YuuFukuyama/RabbitEnvironmentSystem/firmware/usart.md

# USART

STM32F103CBT6 と ESP32-C3 の間は、USART を非同期（UART）で使う。ESP32-C3 側のピン、AT コマンド、給電の電流は [esp32-c3-devkitm-1.md](esp32-c3-devkitm-1.md)、STBee Mini のピン番号は [stbee-mini-v2.md](stbee-mini-v2.md) にある。測定値の並び、応答タイムアウト、再接続の待ちは詳細設計の未決定項目のままである。

## 信号

TX はその部品の送信、RX はその部品の受信である。相手の TX をこちらの RX へ、相手の RX をこちらの TX へつなぐ。

同期モードのクロック（CK）は出さない。CTS と RTS も使わない。フロー制御は無しである。

この型番にあるのは USART1、USART2、USART3 である。USART1 のクロックは APB2 の 72 MHz、USART2 と USART3 は APB1 の 36 MHz である。115200 baud はどちらでも出せる。

ピンを USART の TX または RX に割り当てると、そのピンは GPIO ではなく USART が駆動する。

## 配線

信号と電源は 4 本である。

| STBee Mini | ESP32-C3 基板 |
| --- | --- |
| 31 番 PA9（USART1_TX） | J3 の 9 番（GPIO6、UART1 RX） |
| 32 番 PA10（USART1_RX） | J3 の 8 番（GPIO7、UART1 TX） |
| 39 番 5V | J1 の 13 番または 14 番（シルク 5V） |
| 40 番 GND | GND |

2 番は 39 番と同じ 5 V である。配線に使うのは、PA9 / PA10 と同じ列の 39 番と 40 番である。

論理レベルは 3.3 V。TX はプッシュプルで H も L も駆動するので、外部プルアップは付けない。5 V へプルアップすると、5 V を受けられない ESP32-C3 の GPIO を壊す。

給電は ESP32-C3 基板のシルク 5V へ入れる。このピンは TX / RX の列（J3）ではなく、反対側の列（J1）にあり、Micro-USB の 5 V と同じレールである。基板上の LDO がモジュール用の 3.3 V を作る。STBee Mini の 3.3 V（3 番、38 番）から ESP32-C3 の 3V3 ピンへは給電しない。3V3 ピンは LDO の出力である。Wi-Fi 送信のピークが、STBee Mini の 3.3 V 出力の定格を超える。USB ケーブルを挿したまま、5V ピンへ別の 5 V を入れない。

ESP32-C3 基板のシルク TX / RX（GPIO21 / GPIO20）は、PC への書き込みとログ用である。STM32 はここへつながない。CH340C と信号が衝突する。

## 採用するピン

USART1 を使う。TX は PA9（31 番）、RX は PA10（32 番）である。クロックは APB2 の 72 MHz で、入力は 5 V を受けられる。相手の信号は 3.3 V である。

使わない組は次のとおり。

| 周辺 | TX | RX | 基板ピン | 使わない理由 |
| --- | --- | --- | --- | --- |
| USART2 | PA2 | PA3 | 24 番、25 番 | 5 V 入力は不可。5 V ピンから遠い |
| USART3 | PB10 | PB11 | 14 番、15 番 | このパッケージの I2C2 ピンである |

使わない兼用は次のとおり。

- USART1 の別ピン PB6 / PB7 は I2C1 の SCL / SDA である。
- USART1_CK は PA8（30 番）。同期クロックは出さないので、GPIO のまま空ける。
- USART1 の CTS / RTS（PA11 / PA12）は USB の D− / D+ と兼用である。
- PA13 / PA14 は SWD のまま残す。

## 通信条件

ESP-AT の UART1 に合わせる。

- 115200 baud、8 ビット、パリティなし、ストップ 1。
- 行末は CR LF（`\r\n`）。
- フロー制御なし。
- ボーレートは `AT+UART_DEF` で変えない。115200 のままにする。

## このリポジトリでの割り当て

CubeMX は USART1 を非同期で初期化する。`MX_USART1_UART_Init` が `HAL_UART_Init` を呼び、失敗すると `Error_Handler()` に入る。設定は 115200 baud、8 ビット、パリティなし、ストップ 1、フロー制御なしである。TX は PA9、RX は PA10 で、割り込みは使わない。測定のたびに `AT` と `AT+GMR` を送り、`OK` を読む。`AT+GMR` は応答に `MINI-1` があることも見る。続けて `AT+CWSTATE?` を見る。IP を持っていれば `AT+CWJAP` は送らない。未接続のときだけ `AT+CWMODE=1` と `AT+CWJAP` を送る。SSID とパスワードは `STM32CubeMx/App/wifi_secret.h` に書き、このファイルは git に入れない。失敗しても測定周期は続ける。

- USART1 の TX は PA9（31 番）、RX は PA10（32 番）。ESP32-C3 の UART1 は、GPIO6 が RX、GPIO7 が TX である。
- 給電は 39 番の 5 V を、ESP32-C3 のシルク 5V（J1 の 13 番または 14 番）へ入れる。GND は 40 番である。3 番と 38 番の 3.3 V からは給電しない。
- 5 V 電源は 0.5 A 以上を出せるものとする。Wi-Fi 送信のピークは最大 350 mA、受信は 82 mA である。STM32 本体は約 30 mA で、同じ USB の 5 V から STBee Mini のレギュレータを経由する。10 分に 1 回の送信なら、5 V で 0.5 A 以上出せる USB アダプタか給電ポートでピークは収まる。USB 機器として認識されていない PC ポートは 100 mA しか出さないことがあり、その場合は足りない。
- ESP32-C3 をつないだまま、STBee Mini の 5 V ピンへ 9〜12 V は入れない。リセッタブルヒューズの保持電流はマニュアルに無い。
- 測定と LCD 更新の周期は、USART の成否で変えない。
- AT や Wi-Fi の失敗では `Error_Handler()` に入らない。センサー通信の失敗と同じである。

## 起動時の HTTP（notifyMode 取得）

起動時の操作取得は `GET /v1/ops` である。中継は本文 `0` または `1` の 1 文字だけ返す。本体は `At_BootParseNotifyMode` で読んで `EnvJudge_SetNotifyMode` に渡す。暦は中継から取らず RTC へも書かない。取得失敗時は測定周期を続行し、LCD には診断を出さない。`At_HttpAuthBoot` は `Authorization` ほかと `X-Device-Boot: 1` を `AT+HTTPCHEAD` で載せる。`At_HttpGetBoot` は `ATE0` のあと `AT+HTTPCSNI` を host に合わせ、順に `AT+HTTPCGET="https://<RELAY_HOST>/v1/ops",2048,2048,20000`、host/path 指定の `AT+HTTPCLIENT`、URL 一体型 `AT+HTTPCLIENT` を試す。UART 受信バッファ 2048 バイトで、行頭の `+HTTPCGET:` / `+HTTPCLIENT:` から本文を行末まで連結する（分割 URC と `0`/`1` だけの続き行にも対応）。0/1 が読めるまで、またはタイムアウト（20 s）まで読む。`OK` の後も短いアイドル（約 1.2 s）を含め追加 URC を待つ。連結後は 0/1 1 文字に切り詰める。マージ対象は行頭 URC のみ（`AT+HTTPCLIENT` エコー内の部分一致は除く）。
