YuuFukuyama/RabbitEnvironmentSystem/firmware/gy-sht31-d.md

# GY-SHT31-D 仕様メモ

RASBEE の GY-SHT31-D（Amazon ASIN [B08G4MXGXM](https://www.amazon.co.jp/dp/B08G4MXGXM)、メーカー型番 GY-SHT31-D）は、Sensirion SHT31-DIS を載せた I2C 温湿度モジュールである。販売名の SHT31-D は、デジタル I2C 版（DIS）を指す。

チップの数値と命令は [Datasheet SHT3x-DIS](https://sensirion.com/media/documents/213E6A3B/63A5A569/Datasheet_SHT3x_DIS.pdf)（2022年12月、Version 7）による。端子、基板上の抵抗、販売ページが掲げる範囲と精度は、上記商品ページの記載による。ページ内で数値が食い違う箇所は、その節に両方残す。

## 概要

温度と相対湿度を工場校正済みの 16 bit 値で返す。電源と温度の依存はチップ内で補正されている。

- 湿度の規定範囲は 0〜100 %RH。温度の規定範囲は −40〜125 ℃。
- 精度が出る推奨範囲は 5〜60 ℃、20〜80 %RH。ここを外して長く置くと、特に高湿で湿度が一時的にずれる。例として、80 %RH を超える状態を 60 時間続けると +3 %RH 程度ずれることがある。推奨範囲に戻すと、時間をかけて校正状態に戻る。
- I2C は 7 bit、最大 1 MHz。アドレスは 2 つから選べ、この基板の初期値は `0x44`。
- 測定しないあいだはアイドルになる。アイドルはユーザからは止められない。

チップ上面のレーザ印字の上段が `SHT31` である。`SHT30` の場合、温度の代表精度 ±0.2 ℃の範囲は 0〜65 ℃になり、湿度の公差グラフも別である。

## 販売ページの記載

商品ページが仕様として挙げている値は次のとおり。

| 項目 | ページの記載 |
| --- | --- |
| 電源 | DC 2.4〜5.5 V、代表 3.3 V。仕様表の最大供給電圧は 5.5 V |
| 湿度 | 0〜100 %RH、精度 ±2 %RH。応答は約 8 秒（τ63%） |
| 温度 | −40〜125 ℃、精度 ±0.3 ℃ |
| 出力 | デジタル。インターフェースは I2C、最大 1 MHz。アドレスは 2 つから選べる |
| センサ | SHT31-DIS |
| 実装 | サーフェスマウント |
| アラーム | 温度と湿度の上限・下限をプログラムでき、ALR で知らせる |

同じページのピン説明には、電源を 2.4〜5 V と書いた段と、2.5〜5 V と書いた段がある。箇条書きと仕様表は 5.5 V までである。チップのデータシートは 2.15〜5.5 V。このファームは代表値の 3.3 V で使う。

説明の一節に「アナログ出力」とある。同じページの仕様表はデジタル出力、ピン説明は I2C である。載っているセンサの型番は SHT31-DIS。別の段では「RH応答時間：0〜100 %RH」とあり、これは湿度の範囲と応答時間を取り違えた行である。応答時間として使うのは、約 8 秒（τ63%）の方である。

## 基板

商品ページの端子は次のとおり。ロジックの H レベルは、マイコンと同じ電圧を VIN に入れる。

| 端子 | ページの説明 |
| --- | --- |
| VIN | 電源。チップの VDD |
| GND | 電源とロジックの共通グランド |
| SCL | I2C クロック。VIN へ 10 kΩ でプルアップ |
| SDA | I2C データ。VIN へ 10 kΩ でプルアップ |
| ADR | アドレス選択。10 kΩ でプルダウンされ、開放時は `0x44`。VIN へつなぐと `0x45` |
| RST | ハードウェアリセット。10 kΩ でプルアップされ、開放時は動作状態。GND へ落とすとリセット |
| ALR | アラート出力。温度・湿度が設定範囲を外れたことを出す |

チップ側の対応は、ADR が ADDR、RST が nRESET（アクティブ L、パルス幅は最小 1 µs）、ALR が ALERT である。データシートでは、使わない ALERT はフローティングにする。nRESET を使わないときはフローティング、または 2 kΩ 以上で VDD へつなぐ。この基板は RST を 10 kΩ でプルアップしているので、開放のままでリセットは掛からない。

チップの VDD は 2.15〜5.5 V。2.4 V 未満では測定時間の最大が長くなる。電源ピンの直近には、データシートの推奨どおり 100 nF があるとみなす。センサ開口（チップ中央の穴）は、触れる、塞ぐ、濡らす、溶剤をかける、と測定が壊れる。基板は洗わない。

## 性能

商品ページの精度は、湿度 ±2 %RH、温度 ±0.3 ℃である。SHT31 データシートの代表精度は、湿度が ±2 %RH、温度が ±0.2 ℃（0〜90 ℃）である。最大公差はデータシートのグラフ（湿度は Figure 3 と Figure 6、温度は Figure 9）を見る。湿度の応答約 8 秒（τ63%）は、データシートの 8 s（25 ℃、風速 1 m/s）と一致する。

繰り返し性は、一定条件下で連続測定した標準偏差の 3 倍である。分解能は温度・湿度とも代表 0.01。

| 項目 | 湿度 | 温度 |
| --- | --- | --- |
| 繰り返し性 Low | 0.21 %RH | 0.15 ℃ |
| 繰り返し性 Medium | 0.15 %RH | 0.08 ℃ |
| 繰り返し性 High | 0.08 %RH | 0.04 ℃ |
| ヒステリシス | 25 ℃で ±0.8 %RH | |
| 応答 τ63% | 8 s（25 ℃、風速 1 m/s） | 2 s より長い |
| 長期ドリフト | 代表 <0.25 %RH/年（最大 <0.5） | 最大 <0.03 ℃/年 |

湿度の応答は実装で変わる。ART を有効にすると、湿度の応答時間は約半分になる。温度の応答は熱の逃げ方に依存する。

## 電気とタイミング

代表値は 25 ℃。最小・最大は −40〜125 ℃。

| 項目 | 最小 | 代表 | 最大 | 単位 |
| --- | --- | --- | --- | --- |
| VDD | 2.15 | 3.3 | 5.5 | V |
| パワーオンしきい値 VPOR | 1.8 | 2.10 | 2.15 | V |
| VDD のスルーレート | | | 20 | V/ms |
| アイドル（単発、25 ℃） | | 0.2 | 2.0 | µA |
| アイドル（単発、125 ℃） | | | 6.0 | µA |
| アイドル（周期測定） | | 45 | | µA |
| 測定中 | | 600 | 1500 | µA |
| 単発・最低繰り返し性・1 回/秒の平均 | | 1.7 | | µA |
| ヒータ | 3.6 | | 33 | mW |

VDD を最小と最大のあいだで動かすとき、スルーレートが 20 V/ms を超えるとリセットすることがある。ヒータ電力は電源電圧で変わる。

VDD が 2.4〜5.5 V のときの時間は次のとおり。2.15 V 以上 2.4 V 未満では、パワーアップ最大が 1.5 ms、測定最大が Low 4.5 ms、Medium 6.5 ms、High 15.5 ms になる。

| 項目 | 代表 | 最大 |
| --- | --- | --- |
| パワーアップ（VDD が VPOR 以上になってからアイドルまで） | 0.5 ms | 1 ms |
| ソフトリセット（ACK からアイドルまで） | 0.5 ms | 1.5 ms |
| nRESET パルス幅 | | 最小 1 µs |
| 測定 Low | 2.5 ms | 4 ms |
| 測定 Medium | 4.5 ms | 6 ms |
| 測定 High | 12.5 ms | 15 ms |

絶対最大定格は、VDD が −0.3〜6 V、各ピンが −0.3〜VDD+0.3 V、任意ピンの電流が ±100 mA、保存温度が −40〜150 ℃。動作を保証する範囲ではない。

## I2C

SCL は 0〜1000 kHz。400 kHz までは I2C Fast-mode、それを超えて 1 MHz まではデータシート Table 21 のタイミングに従う。SDA と SCL はオープンドレインで、外部プルアップが要る。バス容量の上限は、1 MHz のタイミング表では 400 pF。

7 bit アドレスは、ADDR が L のとき `0x44`、H のとき `0x45`。ADDR はフローティングにしない。レベルは START からその通信が終わるまで固定する。この基板は ADR を 10 kΩ でプルダウンしているので、開放なら `0x44` になる。VIN へつなぐと `0x45` になる。8 bit で送るアドレスバイトは、`0x44` の書き込みが `0x88`、読み出しが `0x89` である。

命令もデータも 16 bit で、上位バイトが先である。命令の 16 bit には 3 bit の CRC が既に含まれているので、命令のうしろに CRC バイトは付けない。センサが出すデータ、およびマスタが書くデータワードのうしろには 8 bit CRC が付く。書き込みでは CRC が正しいときだけ受け付ける。読み出しの CRC を検査するかはマスタの判断である。

ある命令のあと、次の命令までは 1 ms 以上空ける。各バイトの ACK は、8 個目の SCL の立ち下がり後に SDA を L にすることで示す。

## 単発測定

1 命令で温度と湿度を 1 組測る。繰り返し性で測定時間、ノイズ、測定中の電流量が変わる。クロックストレッチの有無は命令で選ぶ。

| 繰り返し性 | ストレッチ | 命令 |
| --- | --- | --- |
| High | あり | `0x2C06` |
| Medium | あり | `0x2C0D` |
| Low | あり | `0x2C10` |
| High | なし | `0x2400` |
| Medium | なし | `0x240B` |
| Low | なし | `0x2416` |

手順は次のとおり。

```text
START、アドレス+W、命令上位、命令下位、STOP
測定が終わるまで待つ
START、アドレス+R、温度上位、温度下位、CRC、湿度上位、湿度下位、CRC、NACK、STOP
```

温度が先、湿度が後。各値は符号なし 16 bit で、それぞれの直後に CRC がある。マスタは続けて読むバイトに ACK を返す。CRC を含めて 6 バイト読んだあと、最後のバイトには NACK と STOP を出す。CRC や湿度が不要なら、途中のバイトのあとで NACK して止めてよい。湿度も使うなら、温度 2 バイトとその CRC は読み、湿度 2 バイトのあとに NACK する。

ストレッチ無しの命令では、測定が終わっていない読み出しヘッダに NACK が返る。ストレッチありの命令では、読み出しヘッダに ACK したあと、測定が終わるまでセンサが SCL を L に保持する。終わると SCL を離し、6 バイトを送る。

## 周期測定

1 命令のあと、決めた周期で測定を続ける。ストレッチは選べない。結果は Fetch Data `0xE000` で読む。データが無いときの読み出しヘッダは NACK になる。Fetch で読むと、その測定値は消える。

| 周期 | High | Medium | Low |
| --- | --- | --- | --- |
| 0.5 回/秒 | `0x2032` | `0x2024` | `0x202F` |
| 1 回/秒 | `0x2130` | `0x2126` | `0x212D` |
| 2 回/秒 | `0x2236` | `0x2220` | `0x222B` |
| 4 回/秒 | `0x2334` | `0x2322` | `0x2329` |
| 10 回/秒 | `0x2737` | `0x2721` | `0x272A` |

10 回/秒は自己発熱することがある。測定の途中で別の命令を出すときは、先に Break `0x3093` を送る。Break は測定を中止し、約 1 ms で単発モードへ戻る。Fetch だけは Break 無しで出せる。

ART は `0x2B32`。発行後は 4 Hz の周期測定になり、湿度の応答が速くなる。止めるときは Break を使う。

## リセット、ヒータ、ステータス

通信が止まったときは、SDA を H のまま SCL を 9 回以上トグルし、次の命令の前に START を出す。これはインタフェースだけを戻し、ステータスレジスタは残る。

ソフトリセットは `0x30A2`。アイドル中に送り、校正データを読み直してからアイドルへ戻る。戻りまで最大 1.5 ms。校正データは測定の前にも読み直される。リセット後のヒータはオフである。

汎用コールリセットはアドレス `0x00`、2 バイト目 `0x06`。nRESET ピンと同等だが、バス上で汎用コールに対応するデバイスがすべてリセットされる。この基板では RST を GND へ落とすとハードウェアリセットになる。開放時は 10 kΩ のプルアップで解除されている。パルス幅は最小 1 µs。

ヒータは妥当性確認用で、上昇は数 ℃である。オンが `0x306D`、オフが `0x3066`。環境測定のあいだはオフのままにする。

ステータス読み出しは `0xF32D`。戻りは 16 bit と CRC。クリアは `0x3041` で、ビット 15、11、10、4 が 0 になる。

| ビット | 内容 | リセット後 |
| --- | --- | --- |
| 15 | 1 でアラートが残っている | 1 |
| 13 | 1 でヒータオン | 0 |
| 11 | 1 で湿度トラッキングアラート | 0 |
| 10 | 1 で温度トラッキングアラート | 0 |
| 4 | 1 で、クリア後にハードリセット、ソフトリセット、または電源異常があった | 1 |
| 1 | 1 で直前の命令が無効、または命令内 CRC が不一致 | 0 |
| 0 | 1 で直前の書き込み CRC が不一致 | 0 |

14、12、9〜5、3〜2 は予約。

## CRC

データ 16 bit の直後に付く検査符号は CRC-8。対象はその直前の 2 バイトだけである。

| 項目 | 値 |
| --- | --- |
| 多項式 | `0x31`（x^8 + x^5 + x^4 + 1） |
| 初期値 | `0xFF` |
| 入力反転 | しない |
| 出力反転 | しない |
| 最終 XOR | `0x00` |
| 例 | `0xBEEF` の CRC は `0x92` |

## 物理量への変換

生値は符号なし 10 進で式に入れる。分母は 65535（2^16 − 1）である。

```text
湿度[%RH] = 100 × SRH / 65535
温度[℃]  = −45 + 175 × ST / 65535
```

## 扱うときの注意

コマンドとコマンドのあいだは 1 ms 以上空ける。ストレッチ無しで、測定最大時間より前に読むと NACK になる。

周期測定のアイドルは約 45 µA で、単発のアイドル（代表 0.2 µA）より大きい。10 分に 1 回測る用途では単発を使う。

ヒータを入れたままにすると、数 ℃ 高い温度を読む。ALR は使わない。データシートでは、使わない ALERT はフローティングにする。温度と湿度の上下限を書いてアラートを出す機能は商品ページにある。しきい値のレジスタは SHT3x のアラート解説（別紙）にあり、このファームでは使わない。

ハードリセットで電源を切るときは、ESD ダイオード経由で給電されないよう、SDA、SCL、ADDR の電圧も落とす。SCL と SDA のプルアップ元は VIN なので、VIN を切る。ADR を VIN へつなぐ配線をしているときは、その線も一緒に落とす。

## このリポジトリでの割り当て

I2C1 は 100 kHz、PB6 が SCL、PB7 が SDA。同じバスに ST7032i（`0x3E`）がいる。SHT31 の `0x44` とは重ならない。バス全体の取り決めは [i2c.md](i2c.md) にまとめた。

VIN は 3.3 V にする。商品ページの電源範囲の代表値であり、SCL と SDA の 10 kΩ が VIN へプルアップされている。5 V を入れると共有バスの H レベルが 5 V になる。ADR は開放のままにして `0x44` を使う。RST と ALR も開放のままにする。

測定は単発、繰り返し性 High、ストレッチ無し（`0x2400`）にする。3.3 V では測定の最大が 15 ms なので、命令のあと 15 ms 待ってから 6 バイトを読む。温度と湿度の CRC を両方検査する。読めない、NACK、CRC 不一致はセンサ異常として測定を続け、`Error_Handler` には入れない。

取得はこの測定手順で行う。測定間隔は 10 分である。テスト用のダミーシナリオは `ENV_SENSOR_USE_DUMMY` を ON にしたときだけ使う。
