YuuFukuyama/RabbitEnvironmentSystem/firmware/i2c.md

# I2C バス仕様

このファームウェアの I2C に載せるスレーブは、ST7032i と GY-SHT31-D（SHT31-DIS）の 2 個だけである。マスタは STM32F103 の I2C1 が 1 個である。デバイス固有の命令は [st7032i.md](st7032i.md) と [gy-sht31-d.md](gy-sht31-d.md) にあり、ここでは両者が同じ線を使うときの条件だけを書く。

## 接続

論理レベルは 3.3 V に揃える。GY-SHT31-D の SCL と SDA は VIN へ 10 kΩ でプルアップされているので、VIN を 3.3 V にする。ここを 5 V にすると、共有バスの H が 5 V になる。

| 信号 | STM32 | ST7032i | GY-SHT31-D |
| --- | --- | --- | --- |
| SCL | PB6（I2C1_SCL） | SCL | SCL |
| SDA | PB7（I2C1_SDA） | SDA | SDA |
| 電源 | 3.3 V | ロジック電源 | VIN |
| グランド | GND | GND | GND |

GY-SHT31-D の ADR、RST、ALR は開放する。ADR は基板上の 10 kΩ プルダウンで `0x44` になる。RST は 10 kΩ プルアップでリセットが掛からない。ALR はフローティングのままにする。

ST7032i は SDA と SCL のプルアップを必要とする。このバスのプルアップは GY-SHT31-D の 10 kΩ を使う。LCD モジュール側にも抵抗がある場合は並列になり、100 kHz ではそのまま使える。基板を見ずに、さらに抵抗を足さない。

PB6 と PB7 は 5 V トレラントである。バス電圧を決めるのはプルアップの先なので、許容入力であることと、H レベルを 5 V にすることは別である。

## 速度とアドレス

ST7032i の上限は Fast-mode の 400 kHz。SHT31 の上限は 1 MHz。このバスは両方に入る 100 kHz で動かす。

アドレスは 7 bit。2 個は重ならない。

| デバイス | 7 bit | 書き込みバイト | 読み出しバイト |
| --- | --- | --- | --- |
| ST7032i | `0x3E` | `0x7C` | 無し。書き込み専用 |
| SHT31 | `0x44` | `0x88` | `0x89` |

ADR を VIN へつなぐと SHT31 は `0x45` になる。`0x3E` とは重ならないが、このファームウェアは `0x44` で読む。

SHT31 の汎用コールリセット（アドレス `0x00`、2 バイト目 `0x06`）は、バス上で汎用コールに対応するデバイスをまとめてリセットする。このバスでは送らない。SHT31 を戻すときは `0x44` 宛のソフトリセット `0x30A2` を使う。

## マスタ

`MX_I2C1_Init` の設定は次のとおり。

| 項目 | 値 |
| --- | --- |
| ペリフェラル | I2C1 |
| クロック | 100 kHz |
| デューティ | 2 |
| 自アドレス | 0 |
| アドレス長 | 7 bit |
| デュアルアドレス | 無効 |
| 汎用コール | 無効 |
| クロックストレッチ | マスタは受け付ける |

1 回の転送は START から STOP までを 1 デバイスで終える。2 個の転送をバイト単位で混ぜない。SHT31 の測定待ちと、ST7032i の命令実行待ちのあいだはバスが空くので、その間はもう一方へ転送してよい。

各バイトの ACK はスレーブが出す。ST7032i の ACK は Busy フラグではない。SHT31 へストレッチ無しの読み出しを、測定完了前に出すと、読み出しアドレスに NACK が返る。

## ST7032i

書き込み専用である。読み出しはしない。1 転送の並びは次のとおり。

```text
START、0x7C、制御バイト、データバイト、…、STOP
```

制御バイトは、命令が `0x00`、表示データが `0x40`。命令の実行時間を待ってから次の命令を送る。Clear Display と Return Home は、データシートの 380 kHz の例で 1.08 ms、初期化例では Clear のあと 2 ms 待つ。それ以外は 380 kHz の例で 26.3 μs、初期化例では 30 μs より長く待つ。電源が安定してから 40 ms は内部リセット中なので、その間は命令を送らない。フォロワを入れたあとの安定待ちは 200 ms。命令の中身は [st7032i.md](st7032i.md) にある。

## SHT31

10 分に 1 回の測定は、単発、繰り返し性 High、クロックストレッチ無し（`0x2400`）にする。ストレッチありの命令は測定が終わるまで SCL を L に保つので、その間 ST7032i へ書けなくなる。周期測定はアイドル電流が大きく、この周期では使わない。

```text
START、0x88、0x24、0x00、STOP
15 ms 待つ
START、0x89、温度上位、温度下位、CRC、湿度上位、湿度下位、CRC、NACK、STOP
```

3.3 V での測定時間は最大 15 ms なので、待ちは 15 ms にする。この待ちのあいだ SCL は空いている。温度と湿度の CRC を両方検査する。CRC-8 は多項式 `0x31`、初期値 `0xFF`、反転なし、最終 XOR `0x00`。例は `0xBEEF` に対して `0x92`。

```text
湿度[%RH] = 100 × SRH / 65535
温度[℃]  = −45 + 175 × ST / 65535
```

SHT31 の命令と命令のあいだは 1 ms 以上空ける。電源が入ってアイドルになるまでは最大 1 ms。ソフトリセット `0x30A2` のあと、次の命令までは最大 1.5 ms 空ける。ヒータはオフのままにする。

## 起動

3.3 V が安定してから、ST7032i は 40 ms、SHT31 は 1 ms でコマンドを受け付ける。LCD の初期化は 40 ms のあとに行う。取得はこの節の単発測定で行う。測定間隔は 10 分である。

## 通信エラーとタイムアウト

失敗は、そのデバイスだけの失敗と、共有バスが止まった失敗に分ける。復旧は ST7032i と SHT31 の両方の転送の下に 1 つ置く。片方がバスを掴んだまま、もう一方へ進まない。

上の節の待ち（電源後 40 ms、フォロワ後 200 ms、Clear Display の 2 ms、その他の命令は 30 μs より長く、測定 15 ms、命令間隔 1 ms、ソフトリセット後 1.5 ms）は、STOP まで終わったあとに空ける。HAL に渡すタイムアウトには入れない。測定前の読み出しはストレッチせず、読み出しアドレスがすぐ NACK になる。

HAL のタイムアウトは、1 回の START から STOP まででフラグが動かない時間である。100 kHz では ST7032i の 2 バイトも SHT31 の 6 バイト読みも 1 ms 未満なので、転送タイムアウトは 100 ms とする。`HAL_MAX_DELAY` は使わない。

転送に入る前の BUSY 待ちは、HAL 内で 25 ms 固定である。呼び出し側の 100 ms とは別である。SCL が L のままだと、次の転送も 25 ms で `HAL_BUSY` を繰り返す。`Drivers/` の HAL は変更しない。

SHT31 の測定命令はストレッチ無しなので、15 ms のあいだ SCL を掴まない。タイムアウトと `HAL_BUSY` は、スレーブが途中で SCL または SDA を離さないときである。マスタはクロックストレッチを受け付けるので、その待ちは転送タイムアウトまで続く。

ブロッキング API は、戻り値だけでは NACK とタイムアウトを分けない。`ErrorCode` を見る。

| 観測 | 戻り | ErrorCode | バス |
| --- | --- | --- | --- |
| アドレス NACK | `HAL_ERROR` | `HAL_I2C_ERROR_AF` | HAL が STOP を出し、状態は `READY`。バスは空く |
| 転送中のフラグ待ち超過 | `HAL_ERROR` | `HAL_I2C_ERROR_TIMEOUT` | 状態は `READY` に戻る。STOP を出さない経路がある |
| 入りの BUSY 超過 | `HAL_BUSY` | `HAL_I2C_ERROR_TIMEOUT` | SCL が L のままのことがある |
| バスエラー | `HAL_ERROR` | `HAL_I2C_ERROR_BERR` | 電気的な異常 |

呼び出し側は次のとおりにする。

| 結果 | その後 |
| --- | --- |
| `HAL_OK` | 次の処理へ進む |
| `AF`（NACK） | そのデバイスの失敗とする。ペリフェラルはリセットしない |
| CRC 不一致 | センサ異常とする。転送は成功しているので、バス復旧もソフトリセットもしない |
| `TIMEOUT`、`HAL_BUSY`、`BERR` | バスを復旧してから、その転送は失敗とする |

`ST7032_Init` が失敗したら、バス復旧を 1 回して初期化をもう一度だけ試す。それでも失敗なら `Error_Handler` に入る。

周期中の表示更新が失敗しても `Error_Handler` には入らない。失敗したフレームは途中まで書いたままにし、次に成功した周期で 2 行を書き直す。失敗のたびに Clear Display はしない。

SHT31 が応答しない、読み出しアドレスが NACK、CRC が不一致、のときはセンサ異常として測定を続ける。`Error_Handler` には入らない。取り直しは 1 回で、命令、15 ms、6 バイト読み、CRC の一式である。NACK のあと、待ちだけ足して同じ読み出しを繰り返さない。

汎用コールリセットは送らない。ソフトリセット `0x30A2` は、バスが空いていて NACK や CRC 不一致が続いたときだけ送る。次の命令までは 1.5 ms 空ける。タイムアウトの復旧には使わない。

`AF` だけのときは復旧しない。`TIMEOUT`、`HAL_BUSY`、`BERR` のときは、1 転送につき 1 回、次の順でバスを戻す。

1. STOP を出す。
2. BUSY が残っていれば、I2C を止めて SWRST を入れて戻し、`HAL_I2C_Init` で 100 kHz の設定を入れ直す。
3. それでも SDA が L のままなら、PB6 を GPIO にして SCL を 9 クロック出し、STOP 条件を作ってから I2C に戻す。スレーブが SDA を掴んでいるときは、ペリフェラルのソフトリセットだけでは外れない。

復旧のあと、初期化はもう 1 回だけ試す。周期測定の再送は、上の 1 回の取り直しに任せる。
