YuuFukuyama/RabbitEnvironmentSystem/doc/02_schedule.md

# 開発スケジュール

## 1. 全体方針

11月までに、実環境で利用可能な最低限のシステム（MVP）を完成させる。

開発は、以下の順番で進める。

1. 設計確定
2. 部品購入・単体動作確認
3. 基本システム統合
4. 異常判定・通知制御
5. 生存確認・通信異常対応
6. 省電力化
7. 実環境テスト

---

## 2. Phase 1：設計確定

**期間：9月末～10月上旬**

### 作業

- [ ] 要件定義の確定
- [ ] システム構成の確定
- [ ] STM32 / ESP32-C3の役割確定
- [ ] SHT31の採用確定
- [ ] ST7032i LCDの接続仕様確定
- [ ] I2C通信仕様の確定
- [ ] 電源方式の決定
- [ ] LINE通信仕様（中継サーバーを含む）の確定
- [ ] 通知条件の確定
- [ ] 部品の最終選定

### 完了条件

- [ ] 使用する主要部品が決定している
- [ ] システム構成が決定している
- [ ] 通信方式が決定している
- [ ] 電源方式が決定している
- [ ] 通知仕様が決定している

### 成果物

- システム構成図
- 部品構成表
- 通信仕様
- 電源仕様

---

# 3. Phase 2：部品購入・単体動作確認

**期間：10月上旬**

## 3.1 SHT31

- [ ] STM32とSHT31を接続
- [ ] I2C通信確認
- [ ] 温度取得
- [ ] 湿度取得
- [ ] 10分間隔での測定確認

### 完了条件

> STM32からSHT31の温度・湿度を正常に取得できる。

---

## 3.2 ST7032i LCD

- [ ] STM32とLCDを接続
- [ ] I2C通信確認
- [ ] LCD初期化
- [ ] 文字表示
- [ ] 温度表示
- [ ] 湿度表示

### 完了条件

> STM32からLCDへ温度・湿度を表示できる。

---

## 3.3 ESP32-C3

- [ ] ESP32-C3の動作確認
- [ ] Wi-Fi接続
- [ ] 中継サーバー経由のLINE通知テスト

### 完了条件

> ESP32-C3から中継サーバー経由でLINEへメッセージを送信できる。

---

# 4. Phase 3：基本システム統合

**期間：10月中旬**

以下の構成を完成させる。

```text
SHT31
  ↓
STM32
  ↓
ESP32-C3
  ↓
Wi-Fi
  ↓
中継サーバー
  ↓
LINE Messaging API
  ↓
スマートフォン
```

## 作業

- [ ]  SHT31 → STM32の温湿度取得
- [ ]  STM32 → LCDへの表示
- [ ]  STM32 → ESP32-C3へのデータ連携
- [ ]  ESP32-C3 → STM32へのLINE操作の通知
- [ ]  ESP32-C3 → Wi-Fi通信
- [ ]  ESP32-C3 → 中継サーバーへの通信
- [ ]  中継サーバーからLINEへのテスト通知
- [ ]  10分間隔の測定処理
- [ ]  取得した温度・湿度をESP32-C3へ送信
- [ ]  取得した温度・湿度を中継サーバー経由でLINEへ送信
- [ ]  一連の処理を連続して実行できることを確認

## 完了条件

以下の一連の処理が正常に動作すること。

SHT31
  ↓
温度・湿度を取得
  ↓
STM32
  ↓
ESP32-C3
  ↓
Wi-Fi
  ↓
中継サーバー
  ↓
LINE Messaging API
  ↓
スマートフォンに温度・湿度を通知

また、LCDにも温度・湿度が表示されること。

---

# 5. Phase 4：異常判定・通知制御

**期間：10月中旬～下旬**

## 異常判定

- [ ] 温度閾値の実装
- [ ] 湿度閾値の実装
- [ ] 温度・湿度の複合判定
- [ ] 注意・危険・極めて危険の判定
- [ ] 異常状態の保持
- [ ] 正常復帰判定

## 通知制御

- [ ] 異常発生時の通知
- [ ] 通知抑制
- [ ] 危険度に応じた再通知
- [ ] 正常復帰通知
- [ ] 通知内容の整理
- [ ] 閾値設定

## 完了条件

同じ異常による通知が頻発せず、異常の発生・継続・復帰を適切に通知できる。

---

# 6. Phase 5：生存確認・通信異常対応

**期間：10月下旬**

## 生存確認

- [ ] 60分ごとの生存確認通知（起動時にONだった利用者。24時間で自動オフはしない）
- [ ] 生存確認通知のON/OFF（切り替え時は本体のリセットを案内する）
- [ ] 温度・湿度を生存確認通知に含める
- [ ] 通知内容の確認

## Wi-Fi異常

- [ ] Wi-Fi切断検知
- [ ] Wi-Fi再接続
- [ ] 再接続失敗時の動作
- [ ] Wi-Fi復旧後の通信
- [ ] 温湿度測定の継続

## 停電対応

- [ ] 停電の直接検知は実装しない
- [ ] 60分ごとの生存確認通知を代替手段とする。起動時に定期通知がOFFだったあいだは対象外
- [ ] 通知途絶時に考えられる原因を整理する

## 完了条件

60分ごとの生存確認通知により、起動時に定期通知がONだったあいだ、本体が正常に動作していることを外出先から確認できる。

---

# 7. Phase 6：省電力化

**期間：10月下旬**

## 作業

- [ ] ESP32-C3のスリープ検証
- [ ] STM32の低消費電力化
- [ ] 測定間隔10分での消費電力測定
- [ ] Wi-Fi通信時の消費電力測定
- [ ] 60分の生存確認通知を含めた消費電力測定
- [ ] 待機時の消費電力測定
- [ ] モバイルバッテリーでの連続稼働時間測定

## 完了条件

実測値から連続稼働時間を算出し、6か月稼働の実現可能性を判断できる。

※6か月稼働を必ず実現できることを、この時点では要求せず、まず実測する。

---

# 8. Phase 7：実環境テスト

**期間：10月末～11月**

実際の飼育環境に設置してテストする。

## 温湿度

- [ ] 温度測定
- [ ] 湿度測定
- [ ] 10分間隔測定
- [ ] 長時間測定
- [ ] 温湿度の異常判定

## 通知

- [ ] 異常通知
- [ ] 通知抑制
- [ ] 再通知
- [ ] 正常復帰通知
- [ ] 60分の生存確認通知

## 通信

- [ ] Wi-Fi切断
- [ ] Wi-Fi再接続
- [ ] インターネット切断時の動作
- [ ] 通信復旧後の動作

## 電源

- [ ] 長時間連続運転
- [ ] バッテリー残量確認
- [ ] 電源切断時の動作
- [ ] 有線の場合のコード安全性確認

## LCD

- [ ] 温度表示
- [ ] 湿度表示
- [ ] 異常状態表示

---

# 9. 11月時点の完成条件

## MVP（最低限完成させる機能）

- [ ] 温度測定
- [ ] 湿度測定
- [ ] 約10分間隔で測定
- [ ] 温度・湿度の異常判定
- [ ] LINE通知
- [ ] 通知抑制
- [ ] 正常復帰通知
- [ ] LCD表示
- [ ] Wi-Fi再接続
- [ ] 60分ごとの生存確認通知
- [ ] 24時間連続監視

---

# 10. 将来対応

以下はMVP完成後に検討する。

- [ ] カメラによる映像確認
- [ ] 温度上昇時の自動冷却
- [ ] 温湿度履歴の保存・グラフ表示
- [ ] 本格的な停電検知
- [ ] バッテリー残量通知
- [ ] 長期間の消費電力最適化
- [ ] 専用アプリ化

---

# 11. マイルストーン

| マイルストーン | 完了条件 |
|---|---|
| **M1：設計完了** | 部品・通信・電源・通知方式が決定 |
| **M2：センサー動作** | SHT31から温湿度を取得できる |
| **M3：LCD動作** | LCDに温湿度を表示できる |
| **M4：LINE通信** | 中継サーバー経由でLINEへ通知できる |
| **M5：基本統合** | 温湿度 → 判定 → LINE通知が動作する |
| **M6：通知制御** | 異常・継続・復帰を適切に通知できる |
| **M7：生存確認** | 60分ごとの生存確認通知が、起動時にONだった利用者へ届く |
| **M8：省電力検証** | 消費電力・連続稼働時間を実測できる |
| **M9：実環境テスト** | 実際の飼育環境で連続運転できる |
| **M10：11月完成** | MVPの必須機能が利用可能 |

---

# 12. 優先順位

開発中に時間が足りなくなった場合は、以下の順番を優先する。

1. 温度測定
2. 湿度測定
3. 異常判定
4. LINE通知
5. 通知抑制
6. 生存確認通知
7. Wi-Fi再接続
8. LCD表示
9. 省電力化
10. その他の改善機能

カメラ・自動冷却・本格的な停電検知は、11月のMVP完成後に回す。
