YuuFukuyama/RabbitEnvironmentSystem/doc/01_requirements.md

# 要件定義

## 1. 目的

家庭で飼育しているウサギの飼育環境を監視し、外出中でも温度・湿度などの環境状態を確認できるシステムを構築する。

異常値を検知した場合には通知を行い、飼育環境の異常を早期に把握できるようにする。

---

## 2. ヒアリング項目

### 2.1 現状

* 現在、温度をどう確認している？
* どのくらいの頻度で確認している？
* 外出中に温度が気になることはある？
* 温度以外に気になるものはある？

### 2.2 困りごと

* 今の方法で困っていることは？
* 夏場に不安なことは？
* 外出中に知りたい情報は？

### 2.3 要求

* どうなったら便利？
* 通知は必要？
* スマホから確認したい？
* 過去の記録は必要？
* カメラは必要？
* 湿度も必要？

### 2.4 運用

* 24時間動かしたい？
* 停電した場合は？
* Wi-Fiが切れた場合は？
* メンテナンスはどのくらいなら許容できる？

---

## 3. ヒアリング結果

| 項目 | ヒアリング結果 |
| ---- | --- |
| 温度 | 確認したい |
| 湿度 | 確認したい |
| 異常通知 | 外出時を含め、異常値になった場合に通知してほしい |
| 閾値設定 | 異常値の範囲を設定できるようにしたい |
| 通知頻度 | 同じ異常による通知が頻発するのは避けたい |
| 情報確認 | 一つのアプリで完結させたい |
| 停電 | 停電したことを通知してほしい |
| カメラ  | ウサギの様子を確認できるとよい |
| 電源 | 長時間稼働できる場合は充電式が望ましい |
| 有線電源 | コードがある場合は、かじり防止対策が必要 |
| 温度対策 | 温度が高い場合に温度を下げられるとよい |
| 測定間隔 | 約10分間隔でチェックしてほしい |
| 納期 | 冬が来る前の11月までにほしい |

---

# 4. 機能要件

| ID | 要件 | 優先度 | 備考 |
| ---- | --- | --- | --- |
| F-01 | 温度を測定できる | 必須  | |
| F-02 | 湿度を測定できる | 必須  | |
| F-03 | 約10分間隔で環境をチェックする | 必須  | |
| F-04 | 温度・湿度の異常値を設定できる | 必須  | 上限・下限を想定 |
| F-05 | 異常値になった場合に通知する | 必須  | 外出中も通知 |
| F-06 | 同じ異常による通知が頻発しない | 必須  | 通知抑制が必要 |
| F-07 | 温度・湿度・通知などの情報を一つのアプリで確認できる | 必須  | |
| F-08 | 起動時に定期通知がONだったあいだ、60分ごとに生存確認通知を送信できる | 必須  | 通知の途絶から停電・通信異常等の可能性を判断する。途絶で疑うのは、その起動でONを受け取っているあいだ。24時間で自動停止はしない |
| F-08-1 | 生存確認通知のON/OFFを利用者ごとに設定できる | 必須  | 設定は中継が持つ。本体への反映はリセット後。切り替えた返信で本体のリセットを案内する |
| F-08-2 | 生存確認通知に温度・湿度等の状態を含める  | 必須  | 本体の稼働確認を兼ねる |
| F-09 | 24時間連続して監視できる | 必須  | |
| F-10 | 長期間充電せずに連続稼働できる | 希望  | 目標6か月程度 |
| F-11 | 有線電源の場合、コードのかじり対策を行う | 必須  | 安全対策 |
| F-12 | Wi-Fiが切断された場合でも監視を継続する | 必須  | Wi-Fi復旧後に再接続 |
| F-13 | 異常状態から復帰したことを検知できる | 必須  | 通知方法は別途決定 |
| F-14 | 11月までに必須機能を利用可能にする | 必須  | 開発スケジュール上の制約 |
| F-15 | 起動時に中継サーバーから現在時刻を取得できる | 必須  | 電源投入とリセットのあと1回。STOPからの復帰では取らない。失敗しても測定は続ける |
| F-16 | 起動時に定期通知のモードを取得できる | 必須  | 誰かONかだけ。電源投入とリセットのあと1回。未取得のあいだは生存確認を出さない |

---

# 5. 非機能要件

| ID | 要件 | 優先度 |
| ----- | --- | --- |
| NF-01 | 24時間連続稼働できる | 必須  |
| NF-02 | 約10分間隔で測定できる | 必須  |
| NF-03 | 長期間の連続稼働を考慮した省電力設計とする | 必須  |
| NF-04 | Wi-Fi切断から復旧できる | 必須  |
| NF-05 | 電源コードを使用する場合、ウサギが接触・かじることを防止する | 必須  |
| NF-06 | 11月までに必須機能を利用可能な状態にする | 必須  |
| NF-07 | センサー等の交換・メンテナンスが可能な構成とする | 希望  |

---

## 6. 初期開発対象外機能

以下の機能は初期開発では対象外とする。

| ID | 機能 | 優先度 | 備考 |
| ----- | --- | --- | --- |
| OF-01 | カメラによる映像確認 | 希望  | 将来対応 |
| OF-02 | 温度上昇時の自動冷却 | 希望  | 将来対応 |
| OF-03 | 停電の直接検知 | 対象外 | 生存確認通知で代替 |

---

# 7. 温度・湿度監視仕様

## 7.1 測定間隔

温度・湿度の環境チェックは、**約10分間隔**で実施する。

## 7.2 温度閾値

初期値として以下を設定する。

| 状態 | 温度条件 |
| ---- | ---: |
| 低温異常 | 15℃未満 |
| 低温警告 | 15℃以上18℃未満 |
| 正常 | 18℃以上24℃以下 |
| 高温警告 |  24℃超27℃以下 |
| 高温異常 | 27℃超 |

※閾値は初期設定値とし、実際の飼育環境での運用結果をもとに調整する。

## 7.3 異常判定

一時的な温度変化による誤通知を防止するため、異常値を複数回連続して検出した場合に通知する。

初期仕様：

* 測定間隔：10分
* 異常判定：3回連続
* 異常通知までの時間：約30分

## 7.4 ヒステリシス

異常状態と正常状態の境界付近で通知が繰り返されることを防止するため、警告開始条件と解除条件を分ける。

| 状態 | 開始条件  | 解除条件  |
| ---- | ----- | ----- |
| 低温警告 | 15℃未満 | 16℃以上 |
| 高温警告 | 27℃超  | 26℃未満 |

---

# 8. 通知仕様

## 8.1 通知対象

以下の状態を通知対象とする。

* 高温異常
* 低温異常
* 湿度異常
* 停電
* その他システム異常

## 8.2 通知抑制

同じ異常が継続している場合、一定間隔で通知を繰り返すのではなく、異常発生時に通知し、その後は状態が復帰するまで通知を抑制する方式を基本とする。

具体的な再通知条件は詳細設計で決定する。

---

# 9. 電源・停電

## 9.1 電源

長期間の連続稼働を実現するため、電源方式について検討する。

候補：

* USB等による有線電源
* バッテリー
* 充電式バッテリー
* 有線電源＋バックアップバッテリー

## 9.2 停電検知

停電発生時にも通知できるよう、停電を検知する仕組みを構築する。

停電時の通信方法およびバックアップ電源については、システム設計で決定する。

---

# 10. ネットワーク

## 10.1 通常時

ESP32を使用してWi-Fiに接続し、温湿度データおよび異常情報を中継サーバーへ送信する。中継サーバーがLINE Messaging APIを通じてスマートフォンへ通知する。

状態の確認と操作はLINEで行う。LINEからの操作は中継サーバーが受け、次の約10分周期の測定時にESP32からSTM32へ渡して反映する。

電源投入とリセットのあと、STM32は最初に中継と通信できたときに現在時刻と、誰か定期通知がONかを受け取る。STOPからの復帰では受け取らない。LINEで定期通知を切り替えても、本体はリセットまでそのモードを変えない。

## 10.2 Wi-Fi切断時

Wi-Fiが切断された場合でも、STM32による温湿度測定は継続できる構成とする。

Wi-Fi復旧後に必要に応じて状態を再送信する。

---

# 11. 納期

初期目標として、**11月までに必須機能を実装し、実環境での運用を開始する。**

優先順位：

1. 温度測定
2. 湿度測定
3. 異常判定
4. 通知
5. アプリからの状態確認
6. 停電検知
7. その他の改善機能

---

# 12. 未確定事項

以下については今後の設計・検証で決定する。

* [ ] 湿度の具体的な閾値
* [ ] 通知方法
* [ ] 通知の再通知条件
* [ ] 電源方式
* [ ] 6か月連続稼働の実現可能性
* [ ] 停電検知方式
* [ ] Wi-Fi切断時の詳細動作
* [ ] 使用する温湿度センサー
* [ ] データ保存期間
