YuuFukuyama/RabbitEnvironmentSystem/doc/06_test.md

# テスト

## 1. 目的

必須要件が、詳細設計どおりに観測できることを確認する。

実施時期は [02_schedule.md](02_schedule.md) に残し、ここへ作業チェックは写さない。

---

# 2. 範囲

合格の対象は、要件定義の必須項目とする。

| 区分  | ID |
| --- | --- |
| 機能  | F-01〜F-16（F-08-1、F-08-2 を含む） |
| 非機能 | NF-01〜NF-06 |

次は合格条件にしない。

| ID | 扱い |
| ----- | --- |
| F-10  | 希望。本書では試験しない |
| NF-07 | 希望。完了条件にしない |
| OF-01 | カメラ。対象外 |
| OF-02 | 自動冷却。対象外 |
| OF-03 | 停電の直接検知。電源を落として通知を待たない |

F-14 と NF-06 は、9 章の終了条件で判定する。

---

# 3. 合否の正本

期待結果の数値と通知のタイミングは [04_detailed_design.md](04_detailed_design.md) に従う。合否は詳細設計どおりとする。

T-01 の精度比較は [firmware/gy-sht31-d.md](../firmware/gy-sht31-d.md) の ±0.3℃・±2 %RH（推奨範囲内）。境界はダミー（T-10 / T-11、実施済み）で見た。

---

# 4. 段階

単体・結合・システム・実環境の区分は、7 章の各ケースに書く。飼育場所では危険な温湿度を作らない。

---

# 5. 環境

実施のたびに、実施日・場所・基板構成・ファーム識別・`ENV_SENSOR_USE_DUMMY` ON/OFF を残す。

ダミー ON の結果は本番合格に使わない（T-10 / T-11 の判定用ダミーを除く）。UART は見ず、LCD・LED・LINE・中継で観測する。LINE の push が月間上限などで届かないときは、中継 KV の送信履歴（`push-log`、LINE「送信履歴」または `GET /v1/push-log`）を push の代替観測とする。到達確認は別途済みとする。

---

# 6. ケースの見方

定義は 7 章、合否は 10 章。合否は合格・不合格・未実施（理由あり）。

未決定の数値（再接続秒数、再送回数など）の一致は合格条件にしない。詳細設計 32 章の未決定項目も合格条件にしない。

総合 DANGER、片側解除のヒステリシス、DANGER/CRITICAL への時間昇格、CRITICAL 周期通知、中継 11.4 の push 省略、401・未許可 LINE、インターネットのみ切断は、本書では個別ケースにしない。

---

# 7. テストケース

## 7.1 測定（合格済み）

| ID | 要件 | 操作・期待結果（要約） |
| ---- | --- | --- |
| T-01 | F-01、F-02 | ダミー OFF。基準計と ±0.3℃・±2 %RH。S37 消灯 |
| T-02 | F-03、NF-02 | 約 10 分周期 3 周期以上。正常時基板 LED 消灯 |
| T-03 | 詳細設計 28 章 | SHT31 不通でも `Error_Handler` に入らず周期継続。LCD `S.ERR`、S56 点灯 |
| T-04 | 詳細設計 22・28 章  | 起動前から LCD 不通 → 初期化失敗で `Error_Handler` |
| T-05 | 詳細設計 22・28 章  | 周期中 LCD 失敗でも測定継続。次成功周期で 2 行書き直し |

## 7.2 判定（合格済み）

| ID | 要件 | 操作・期待結果（要約） |
| ----- | ---- | --- |
| T-10  | F-04 | ダミー境界シナリオ（`ENV_SENSOR_DUMMY_BOUNDARY_TEST`）で温度 8 点の帯判定 |
| T-11  | F-04 | 同シナリオで湿度 8 点の帯判定。異常時 S56・基板 LED 点灯 |

手順と期待値の周期表は、実施時のファーム（`STM32CubeMx/App/env_dummy.c`）と CMake オプションを正本とする。

## 7.3 起動・LINE（合格済み）

| ID | 要件 | 操作・期待結果（要約） |
| ---- | --- | --- |
| T-30 | F-15、F-16 | 起動・リセット後の boot GET のみで `notifyMode` 取得。STOP 復帰では取り直さない |
| T-33 | F-08、F-16 | 常に通知モードでない起動 → 生存確認なし。測定・異常通知は継続 |
| T-35 | F-07 | 「いまの状態」で最新 1 件（ダミー ON で確認済み。本番代表は T-50） |
| T-50 | F-05、F-07 | ダミー OFF 1 周期。LCD・中継履歴・条件付き LINE |

## 7.4 残り（本番・ダミー OFF）

| ID | 要件 | 段階 | 操作 | 期待結果 |
| ---- | --- | ---- | --- | ---- |
| T-20 | F-05、F-06、F-13（復帰は任意） | システム | 温度だけ WARNING を 3 周期。任意で NORMAL に戻す | 1・2 周期目は異常 LINE なし。3 周期目に【環境異常】1 件（「注意」、温湿度含む）。任意で【正常復帰】1 件 |
| T-40 | F-08、F-08-1、F-08-2、F-09、F-11、F-12、NF-01、NF-04、NF-05 | 実環境  | ① LINE で通知設定を切替→リセットし、設定どおりに生存確認の有無が変わること。② 有線ならコード目視。③ 測定中に AP を 1 回切り、続行を確認して AP を戻し次周期まで待つ。④ 誰かが常に通知モードの状態で 24 時間連続（飼育場所可） | 切断中も測定・LCD 継続。復旧後最新のみ中継へ。S1 は Wi-Fi 接続成功時点灯。約 10 分周期が 24 時間続く。60 分ごと【定期通知】（温湿度・危険度）。24 時間で定期が止まらない。有線時コードはウサギが接触・かじれない。途絶を停電と断定しない旨をメモしてよい |

---

# 8. 要件の追跡

合否は 10 章と揃える。

| 要件 | ケース |
| --- | --- |
| F-01〜02 | T-01 |
| F-03 | T-02 |
| F-04 | T-10、T-11 |
| F-05 | T-20、T-50 |
| F-06 | T-20 |
| F-07 | T-50 |
| F-08 | T-33、T-40 |
| F-08-1 | T-40 |
| F-08-2 | T-40 |
| F-09 | T-40 |
| F-10 | — |
| F-11 | T-40（有線時） |
| F-12 | T-40 |
| F-13 | T-20（任意） |
| F-14 | 9 章 |
| F-15 | T-30 |
| F-16 | T-30、T-33 |
| NF-01  | T-40 |
| NF-02  | T-02 |
| NF-03  | T-02（STOP 代表） |
| NF-04  | T-40 |
| NF-05  | T-40（有線時） |
| NF-06  | 9 章 |

| 詳細設計（要件 ID なし） | ケース |
| --- | --- |
| センサー失敗継続、LCD 障害 | T-03〜T-05、T-10/T-11 |
| 起動時 ops 1 回 | T-30 |
| 中継 11.4、401 等 | 本書外 |

---

# 9. 終了条件

- 10 章の **T-20** と **T-40** が合格、または未実施理由がある。
- 10 章の合格済み行のうち本番に使うものはダミー OFF（T-10 / T-11 のみ ON 可）。
- 8 章の必須要件が上記で満たされている。不合格は 11 章。OF-01〜03 は実施しない。

F-14 / NF-06 は 11 月利用開始までに上記が揃っていること。

---

# 10. 実施記録

| ID | 合否  | 実施日 | ダミー | 実測メモ |
| ---- | --- | --- | --- | --- |
| T-01 | 合格  | 2026/10/15 | OFF | 別温度系との大幅な誤差なし |
| T-02 | 合格  | 2026/10/15 | OFF | 3周期動作確認 |
| T-03 | 合格  | 2026/10/15 | OFF | 初回と2周期目にSHT31基盤を未接続にて確認 |
| T-04 | 合格  | 2026/10/25 | OFF | |
| T-05 | 合格  | 2026/10/25 | OFF | 定期通知MODEで確認 |
| T-10 | 合格  | 2026/10/25 | ON  | |
| T-11 | 合格  | 2026/10/25 | ON  | |
| T-20 | | | | |
| T-30 | 合格  | 2026/10/25 | OFF | |
| T-33 | 合格  | 2026/10/25 | OFF | |
| T-35 | 合格  | 2026/10/15 | ON  | 本番代表は T-50 |
| T-40 | | | | ①〜④の実施順をメモ |
| T-50 | 合格  | 2026/10/25 | OFF | |

---

# 11. 不具合

| 番号  | 関連ケース | 内容  | 扱い  |
| --- | ----- | --- | --- |
| | | | |
