YuuFukuyama/RabbitEnvironmentSystem/STM32CubeMx/Core/Src/main.c

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
/* Includes ------------------------------------------------------------------*/
#include "main.h"

/* USER CODE BEGIN Includes */
#include "app_clock.h"
#include "app_cycle.h"
#include "env_config.h"
#include "st7032.h"
/* USER CODE END Includes */

I2C_HandleTypeDef hi2c1;

RTC_HandleTypeDef hrtc;

UART_HandleTypeDef huart1;

/* USER CODE BEGIN PV */
static uint8_t lse_ready;
static uint8_t rtc_ready;
/* USER CODE END PV */

void SystemClock_Config(void);
static void MX_GPIO_Init(void);
static void MX_I2C1_Init(void);
static void MX_RTC_Init(void);
static void MX_USART1_UART_Init(void);
/* USER CODE BEGIN PFP */
static HAL_StatusTypeDef RTC_EnableLSE(void);
static HAL_StatusTypeDef RTC_WaitWrite(void);
static uint32_t RTC_ReadCounter(void);
static HAL_StatusTypeDef RTC_ArmAlarm(uint32_t seconds);
/* USER CODE END PFP */

/* USER CODE BEGIN 0 */
static HAL_StatusTypeDef RTC_EnableLSE(void)
{
  RCC_PeriphCLKInitTypeDef periph_clk = {0};
  uint32_t tickstart;

  __HAL_RCC_PWR_CLK_ENABLE();
  SET_BIT(PWR->CR, PWR_CR_DBP);
  tickstart = HAL_GetTick();
  while (READ_BIT(PWR->CR, PWR_CR_DBP) == 0U)
  {
    if ((HAL_GetTick() - tickstart) > RCC_DBP_TIMEOUT_VALUE)
    {
      return HAL_TIMEOUT;
    }
  }

  if (__HAL_RCC_GET_FLAG(RCC_FLAG_LSERDY) == RESET)
  {
    __HAL_RCC_LSE_CONFIG(RCC_LSE_ON);
    tickstart = HAL_GetTick();
    while (__HAL_RCC_GET_FLAG(RCC_FLAG_LSERDY) == RESET)
    {
      if ((HAL_GetTick() - tickstart) > LSE_STARTUP_TIMEOUT)
      {
        return HAL_TIMEOUT;
      }
    }
  }

  periph_clk.PeriphClockSelection = RCC_PERIPHCLK_RTC;
  periph_clk.RTCClockSelection = RCC_RTCCLKSOURCE_LSE;
  return HAL_RCCEx_PeriphCLKConfig(&periph_clk);
}

static uint32_t RTC_ReadCounter(void)
{
  uint16_t high1;
  uint16_t high2;
  uint16_t low;

  high1 = (uint16_t)(hrtc.Instance->CNTH & RTC_CNTH_RTC_CNT);
  low = (uint16_t)(hrtc.Instance->CNTL & RTC_CNTL_RTC_CNT);
  high2 = (uint16_t)(hrtc.Instance->CNTH & RTC_CNTH_RTC_CNT);
  if (high1 != high2)
  {
    low = (uint16_t)(hrtc.Instance->CNTL & RTC_CNTL_RTC_CNT);
    return (((uint32_t)high2) << 16) | low;
  }
  return (((uint32_t)high1) << 16) | low;
}

static HAL_StatusTypeDef RTC_ArmAlarm(uint32_t seconds)
{
  uint32_t alarm;

  if (RTC_WaitWrite() != HAL_OK)
  {
    return HAL_TIMEOUT;
  }
  SET_BIT(hrtc.Instance->CRL, RTC_CRL_CNF);
  if (RTC_WaitWrite() != HAL_OK)
  {
    return HAL_TIMEOUT;
  }

  /* カウンタは 1 秒。次の測定まで止める。 */
  alarm = RTC_ReadCounter() + seconds;
  hrtc.Instance->ALRH = (uint16_t)(alarm >> 16);
  if (RTC_WaitWrite() != HAL_OK)
  {
    return HAL_TIMEOUT;
  }
  hrtc.Instance->ALRL = (uint16_t)(alarm & 0xFFFFU);
  if (RTC_WaitWrite() != HAL_OK)
  {
    return HAL_TIMEOUT;
  }
  CLEAR_BIT(hrtc.Instance->CRL, RTC_CRL_CNF);
  if (RTC_WaitWrite() != HAL_OK)
  {
    return HAL_TIMEOUT;
  }
  if ((hrtc.Instance->CRL & RTC_CRL_CNF) != 0U)
  {
    return HAL_ERROR;
  }

  hrtc.Instance->CRL &= (uint16_t)~RTC_FLAG_ALRAF;
  if (RTC_WaitWrite() != HAL_OK)
  {
    return HAL_TIMEOUT;
  }
  SET_BIT(hrtc.Instance->CRH, RTC_CRH_ALRIE);
  if (RTC_WaitWrite() != HAL_OK)
  {
    return HAL_TIMEOUT;
  }

  __HAL_RTC_ALARM_EXTI_ENABLE_RISING_EDGE();
  __HAL_RTC_ALARM_EXTI_ENABLE_IT();
  __HAL_RTC_ALARM_EXTI_CLEAR_FLAG();
  HAL_NVIC_ClearPendingIRQ(RTC_Alarm_IRQn);
  return HAL_OK;
}

static HAL_StatusTypeDef RTC_WaitWrite(void)
{
  uint32_t tickstart;

  tickstart = HAL_GetTick();
  while ((hrtc.Instance->CRL & RTC_CRL_RTOFF) == 0U)
  {
    if ((HAL_GetTick() - tickstart) > RTC_TIMEOUT_VALUE)
    {
      return HAL_TIMEOUT;
    }
  }
  return HAL_OK;
}
/* USER CODE END 0 */

/**
  * @brief  The application entry point.
  * @retval int
  */
int main(void)
{

  /* MCU Configuration--------------------------------------------------------*/

  /* Reset of all peripherals, Initializes the Flash interface and the Systick. */
  HAL_Init();

  /* Configure the system clock */
  SystemClock_Config();

  /* USER CODE BEGIN SysInit */
  if (RTC_EnableLSE() == HAL_OK)
  {
    lse_ready = 1U;
  }
  /* USER CODE END SysInit */

  /* Initialize all configured peripherals */
  MX_GPIO_Init();
  MX_I2C1_Init();
  MX_RTC_Init();
  MX_USART1_UART_Init();
  /* USER CODE BEGIN 2 */
  if (ST7032_Init(&hi2c1) != HAL_OK)
  {
    Error_Handler();
  }
  AppClock_SetHardwareReady(rtc_ready);
  if (rtc_ready != 0U)
  {
    HAL_NVIC_SetPriority(RTC_Alarm_IRQn, 0, 0);
    HAL_NVIC_EnableIRQ(RTC_Alarm_IRQn);
  }
  /* USER CODE END 2 */

  /* Infinite loop */
  /* USER CODE BEGIN WHILE */
  while (1)
  {
    /* USER CODE END WHILE */

    /* USER CODE BEGIN 3 */
    {
      uint32_t now_sec;

      if (rtc_ready != 0U)
      {
        now_sec = RTC_ReadCounter();
      }
      else
      {
        now_sec = HAL_GetTick() / 1000U;
      }

      App_MeasureOnce(&hi2c1, now_sec);

      if (rtc_ready != 0U)
      {
        if (RTC_ArmAlarm(MEASURE_INTERVAL_SEC) != HAL_OK)
        {
          HAL_Delay((uint32_t)MEASURE_INTERVAL_SEC * 1000U);
        }
        else
        {
          HAL_SuspendTick();
          HAL_PWR_EnterSTOPMode(PWR_LOWPOWERREGULATOR_ON, PWR_STOPENTRY_WFI);
          SystemClock_Config();
          HAL_ResumeTick();
        }
      }
      else
      {
        HAL_Delay((uint32_t)MEASURE_INTERVAL_SEC * 1000U);
      }
    }
  }
  /* USER CODE END 3 */
}

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
