YuuFukuyama/RabbitEnvironmentSystem/STM32CubeMx/App/env_dummy.c

/* 温湿度のダミー取得。100 件を繰り返す。 */

#include "env_sensor.h"

#if !defined(ENV_SENSOR_USE_DUMMY)
#error ENV_SENSOR_USE_DUMMY を外すときは env_dummy.c を本番取得に差し替える
#endif

/* ダミー 1 件。fail が 1 のときは温湿度を使わない。 */
typedef struct
{
  int16_t temp_deci_c;
  int16_t hum_deci_rh;
  uint8_t fail;
} EnvDummyStep;

#define S(temp_deci, hum_deci) { (int16_t)(temp_deci), (int16_t)(hum_deci), 0U }
#define F() { 0, 0, 1U }
#define S2(temp_deci, hum_deci) S(temp_deci, hum_deci), S(temp_deci, hum_deci)
#define S3(temp_deci, hum_deci) S2(temp_deci, hum_deci), S(temp_deci, hum_deci)
#define S4(temp_deci, hum_deci) S2(temp_deci, hum_deci), S2(temp_deci, hum_deci)
#define S5(temp_deci, hum_deci) S4(temp_deci, hum_deci), S(temp_deci, hum_deci)
#define S7(temp_deci, hum_deci) S5(temp_deci, hum_deci), S2(temp_deci, hum_deci)
#define F3() F(), F(), F()

/* 境界試験の前に NORMAL へ戻す。T-10 は湿度 50 %RH、T-11 は 22.0℃。 */
#define BOUNDARY_BASE_T  S(225, 500)
#define BOUNDARY_BASE_H  S(220, 500)
#define BOUNDARY_T(temp_deci) BOUNDARY_BASE_T, S((temp_deci), 500)
#define BOUNDARY_H(hum_deci)  BOUNDARY_BASE_H, S(220, (hum_deci))

#if defined(ENV_SENSOR_DUMMY_BOUNDARY_TEST)

/* T-10 / T-11 の 8 点ずつ。各点の 2 周期目（境界値）を LCD で見る。 */
static const EnvDummyStep env_dummy_steps[] =
{
  BOUNDARY_T(100),
  BOUNDARY_T(101),
  BOUNDARY_T(179),
  BOUNDARY_T(180),
  BOUNDARY_T(259),
  BOUNDARY_T(260),
  BOUNDARY_T(279),
  BOUNDARY_T(280),
  BOUNDARY_H(150),
  BOUNDARY_H(151),
  BOUNDARY_H(399),
  BOUNDARY_H(400),
  BOUNDARY_H(599),
  BOUNDARY_H(600),
  BOUNDARY_H(699),
  BOUNDARY_H(700)
};

#elif defined(ENV_SENSOR_DUMMY_RISK_TEST)

/* T-12〜T-15。各ケースの前後は 22.5℃・50 %RH で NORMAL に戻す。 */
static const EnvDummyStep env_dummy_steps[] =
{
  /* T-12: 温度のみ WARNING → 総合 WARN */
  S2(225, 500),
  S2(179, 500),
  /* T-12: 湿度のみ WARNING → 総合 WARN */
  S2(225, 500),
  S2(220, 399),
  /* T-12: 両方 WARNING → 総合 DANG */
  S2(225, 500),
  S2(260, 600),
  /* T-12: 温度 CRITICAL → 総合 CRIT */
  S2(225, 500),
  S2(280, 500),
  /* T-12: 湿度 CRITICAL → 総合 CRIT */
  S2(225, 500),
  S2(220, 700),
  /* T-13: 総合 DANG のまま片側だけ NORMAL 域へ */
  S2(225, 500),
  S2(260, 600),
  S2(260, 500),
  S2(265, 650),
  S3(225, 500),
  /* T-13: 総合 CRIT のまま WARNING 域へ */
  S2(225, 500),
  S2(280, 500),
  S2(260, 500),
  S3(225, 500),
  /* T-14: 低温 WARNING。18.9℃は解除せず 19.0℃で解除 */
  S2(225, 500),
  S2(170, 500),
  S2(189, 500),
  S2(190, 500),
  /* T-14: 高温 WARNING。17.9℃は解除せず 25.9℃で解除 */
  S2(225, 500),
  S2(260, 500),
  S2(179, 500),
  S2(259, 500),
  /* T-14: 乾燥 WARNING。40.9 %RH は解除せず 41.0 %RH で解除 */
  S2(225, 500),
  S2(220, 350),
  S2(220, 409),
  S2(220, 410),
  /* T-14: 高湿 WARNING。59.0 %RH は解除せず 58.0 %RH で解除 */
  S2(225, 500),
  S2(220, 650),
  S2(220, 590),
  S2(220, 580),
  /* T-14: CRITICAL 帯はヒステリシスなし。内側へ戻すと WARNING へ */
  S2(225, 500),
  S2(100, 500),
  S2(101, 500),
  S2(225, 500),
  S2(280, 500),
  S2(279, 500),
  S2(225, 500),
  S2(220, 150),
  S2(220, 151),
  S2(225, 500),
  S2(220, 700),
  S2(220, 699),
  /* T-15: WARNING 2 周期 → NORMAL → WARNING 2 周期（2 周期目で初回通知） */
  S2(225, 500),
  S2(260, 500),
  S(225, 500),
  S2(260, 500)
};

#else

/* 測定ごとに 1 行進み、末尾の次は先頭に戻る。失敗行はその周期を失敗にする。 */
static const EnvDummyStep env_dummy_steps[] =
{
  /* 正常値が一度もない取得失敗 */
  F3(),
  /* 正常 */
  S4(225, 500),
  /* 低温警告。18.5℃では解除せず、19.0℃で解除する */
  S2(170, 500),
  S(225, 500),
  S2(170, 500),
  S4(185, 500),
  S(190, 500),
  S4(225, 500),
  /* 高温警告。26℃未満の正常帯は NORMAL に戻す。連続は昇格の 6 間隔未満 */
  S4(260, 500),
  S2(245, 500),
  S(235, 500),
  S5(225, 500),
  /* 乾燥警告。40.5% では解除せず、41% で解除する */
  S4(220, 300),
  S2(220, 405),
  S(220, 410),
  S5(225, 500),
  /* 高湿度警告。59.5% では解除せず、58% で解除する */
  S4(220, 650),
  S2(220, 595),
  S(220, 580),
  S5(225, 500),
  /* 両方 WARNING で DANGER。片側が戻っても維持する */
  S(265, 650),
  S2(265, 500),
  S3(225, 500),
  /* 高温・低温・乾燥・高湿の CRITICAL */
  S2(285, 500),
  S3(225, 500),
  S2(95, 500),
  S3(225, 500),
  S2(220, 100),
  S3(225, 500),
  S2(220, 750),
  S3(225, 500),
  /* 直前値がある状態の取得失敗 */
  F3(),
  /* 高温警告を続け、6 間隔で DANGER へ上げる */
  S7(260, 500),
  /* 複合 DANGER を続け、3 間隔で CRITICAL へ上げる */
  S4(265, 650),
  /* 正常へ戻す */
  S3(225, 500)
};

#endif

#define ENV_DUMMY_STEP_COUNT ((uint8_t)(sizeof(env_dummy_steps) / sizeof(env_dummy_steps[0])))

#if defined(ENV_SENSOR_DUMMY_BOUNDARY_TEST)
_Static_assert(sizeof(env_dummy_steps) / sizeof(env_dummy_steps[0]) == 32U,
               "boundary dummy scenario length");
#elif defined(ENV_SENSOR_DUMMY_RISK_TEST)
_Static_assert(sizeof(env_dummy_steps) / sizeof(env_dummy_steps[0]) == 103U,
               "risk dummy scenario length");
#else
_Static_assert(sizeof(env_dummy_steps) / sizeof(env_dummy_steps[0]) == 100U,
               "dummy scenario length");
#endif

/* シナリオの現在位置。末尾の次は 0 に戻る。 */
static uint8_t step_index;

/* シナリオ位置を 1 つ進める。 */
static void advance_step(void)
{
  step_index++;
  if (step_index >= ENV_DUMMY_STEP_COUNT)
  {
    step_index = 0U;
  }
}

HAL_StatusTypeDef EnvSensor_Read(I2C_HandleTypeDef *hi2c, EnvReading *reading)
{
  const EnvDummyStep *step;

  /* ダミーはバスを使わない。 */
  (void)hi2c;

  if (reading == NULL)
  {
    return HAL_ERROR;
  }

  step = &env_dummy_steps[step_index];
  advance_step();
  if (step->fail != 0U)
  {
    reading->temp_deci_c = 0;
    reading->hum_deci_rh = 0;
    reading->ok = 0U;
    return HAL_ERROR;
  }

  reading->temp_deci_c = step->temp_deci_c;
  reading->hum_deci_rh = step->hum_deci_rh;
  reading->ok = 1U;
  return HAL_OK;
}
