YuuFukuyama/RabbitEnvironmentSystem/STM32CubeMx/App/at_cmd.h

#ifndef AT_CMD_H
#define AT_CMD_H

/* ESP32-C3 の AT ポートへ、測定周期に 1 回だけ問い合わせる。 */

#include "stm32f1xx_hal.h"

/* AT、AT+GMR、未接続なら Wi-Fi 参加を行う。失敗しても周期は止めない。 */
HAL_StatusTypeDef At_Probe(void);

/* 再接続を止めてから AP を切る。失敗しても周期は止めない。 */
HAL_StatusTypeDef At_Disconnect(void);

/* 以降の HTTP に Authorization と Content-Type を付ける。 */
HAL_StatusTypeDef At_HttpAuth(const char *token);

/* 起動時 ops 用。X-Device-Boot: 1 を付ける。 */
HAL_StatusTypeDef At_HttpAuthBoot(const char *token);

/* HTTPS GET を行い、応答を At_HttpResponse に残す。 */
HAL_StatusTypeDef At_HttpGet(const char *url);

/* 起動時 ops 用 GET。path にクエリを含めて host と分ける。 */
HAL_StatusTypeDef At_HttpGetBoot(const char *host, const char *path);

/* HTTPS POST の本文を送り、応答を At_HttpResponse に残す。 */
HAL_StatusTypeDef At_HttpPost(const char *url, const char *body);

/* 直前の HTTP 応答。 */
const char *At_HttpResponse(void);

/* 直前の boot GET。+HTTPCLIENT の data 部を連結した本文。 */
const char *At_HttpBootBody(void);

/* boot GET 本文から notifyMode 0/1 を読む。 */
uint8_t At_BootParseNotifyMode(const char *text, uint8_t *mode);

#endif
