YuuFukuyama/RabbitEnvironmentSystem/STM32CubeMx/App/wifi_secret.example.h

#ifndef WIFI_SECRET_H
#define WIFI_SECRET_H

/* この例を wifi_secret.h にコピーして、SSID とパスワードを書く。wifi_secret.h は git に入れない。 */

#define WIFI_SSID ""
#define WIFI_PASS ""

/* 中継のホスト名。スキームは付けない。例は name.workers.dev */
#define RELAY_HOST ""

/* 中継の Secret DEVICE_TOKEN と同じ値。リポジトリには書かない。 */
#define DEVICE_TOKEN ""

#endif
