YuuFukuyama/RabbitEnvironmentSystem/(commit log)

2026-09-25 見出し修正
2026-09-27 基本設計まで作成
2026-09-27 使用調整
2026-09-27 詳細設計を本採用
2026-09-27 ミス修正
2026-10-01 Ledを光らすだけのコードアップ I2Cの初期設定だけはやっている
2026-10-02 LCDテストプログラム作成
2026-10-02 コントラストを弱める
2026-10-02 RTCを有効にした
2026-10-02 RTC復帰によるSTOP処理を追加
2026-10-03 RTC周り修正
2026-10-03 RTCわりこみしゅうせい
2026-10-03 アラームをセットしたあと、RTC の書き込み完了を待ってから古いフラグを消し、その後で割り込みを許可するようにしました。割り込み処理側も、SysTick が止まっていてもフラグを消して戻れるようにしています。STOP の直前に LED を消灯レベルへ固定していた処理は外したので、復帰のたびにトグルします。
2026-10-03 一旦ストップの除外
2026-10-03 液晶とカウンタの切り分け
    1 行目は今どおり HH:MM:SS、2 行目に RTC と無関係なループ回数 L:0000 を出す。LED の点滅は判定に使わない。
    判定は次のとおり。
    2 行目の数字が進み、1 行目が 00:00:00 のまま: 液晶への再描画は成功している。HAL_RTC_GetTime() の読み値が 0 のまま。
    両方とも最初の表示から変わらない: 2 回目以降の I2C 書き込みが画面に届いていない。
    両方進む: カウンタも液晶も更新できている。
    TEST 側の 3 秒点滅と LSE の 5 秒待ちは変えない。
2026-10-03 RTCのカウンターが進まなかったので修正
2026-10-03 読み出す前に、RTC レジスタの同期完了（RSF）を待つようにしました。前回の書き込みは完了していましたが、F1 では同期前のカウンタ読み出しが 0 のまま残ることがあります。
    1 行目の見方は次のとおりです。
    秒が進む: カウンタを読めています。
    NO SYNC になる: RTC クロックのコピーが完了していません。2 行目の L: はこれまでどおり増えます。
2026-10-03 次にお願いしたいこと いつもの環境でビルドして書き込み、LCD の表示を教えてください。
    1 行目 2 行目 F: 判断
    GET ERR
    32768 前後
    ソフト側の問題なので、エラーの原因を直します
    時刻が進む
    32768 前後
    解決です。片付けに進みます
    止まったまま
    0 か、大きく外れた値
    32.768 kHz の水晶まわりのハードウェアの問題です
    ハードウェアの問題だった場合は、次の点の確認手順をお渡しします。
    VBAT 端子が VDD につながっているか
    水晶の負荷容量（CL）と、PC14/PC15 に付いているコンデンサの値
    PC14/PC15 の配線が長すぎないか
2026-10-03 5Vで繋いでたので３．３V用に修正
2026-10-03 RTC アラームで STOP する
    VBAT 接続前はカウンタが止まっていたため、アラームが来ず STOP から戻れなかった。今はカウンタが進むので、1秒ごとに起こして HH:MM:SS を更新する。待っているあいだは STOP（低電力レギュレータ）にし、HSE と CPU を止める。TEST の 3 秒点滅はそのままにする。
    ループ
    STM32CubeMx/Core/Src/main.c の rtc_ready 側を次の順にする。
    LCD_ShowRtc() で 1 行目だけ更新する。失敗しても Error_Handler() には入らない。
    次の秒のアラームを仕掛ける。失敗したときは STOP に入らず HAL_Delay(1000) でやり直す。
    LED を消す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
2026-10-03 更新間隔を10秒に変更
2026-10-04 温度と湿度判定詳細を記載
    システムの状態と特定の閾値を含む、温度・湿度条件の表を更新しました。
2026-10-04 詳細設定を修正
2026-10-04 温湿度の異常判定とダミー入出力を追加する
    詳細設計の閾値で危険度を判定し、LCD に本番の表示を出す。センサーと Wi-Fi は基板が来るまでダミーにし、測定周期はダミー中 10 秒、本番取得では 10 分にする。
2026-10-04 NORMALとそれ以外のLCDの表示内容を変更 LCDのハード仕様を追加
2026-10-04 frmwareドキュメントを追加
2026-10-04 ダミー動作中にLCDに▲アイコンを表示するように変更
2026-10-05 USART周りの仕様と資料を追加 LineのUI構成を追記
2026-10-06 仕様変更で中継サーバーは使用するように変更
2026-10-10 サーバー周りの仕様調整
2026-10-11 ESP32の仕様追記
2026-10-11 USART1を使用できるよう変更
2026-10-11 ESP32との接続テスト
2026-10-11 EPS32テスト２
2026-10-11 ATコマンドの実装テスト
2026-10-11 Wi-Fi接続
    SSID とパスワードはソースに書いていません。STM32CubeMx/App/wifi_secret.h の WIFI_SSID と WIFI_PASS を埋めてから書き込んでください。このファイルは git に入りません。いまは空なので、このまま書き込むと参加コマンドは出ません。
2026-10-11 Wi-Fi接続時はアンテナマークをLCDに出す
2026-10-11 STM32とサーバー周りの対応
2026-10-11 正常な取得が一度もないあいだは、測定を送りません。LCD の NO DATA と同じです。 環境が正常なときのセンサー異常は、正常復帰として送りません。 警告だけでは正常復帰を送らないようにしました。警告の初回と再通知はこれまで通り出します。
2026-10-15 温度センサー処理追加
2026-10-15 １０分計測に変更
2026-10-15 温度の閾値を変更し反映
2026-10-15 テスト仕様を追加
2026-10-18 公開用に調整
2026-10-24 LINEへの通知設定を３段階に変更
2026-10-24 Lineの通知回数状況を送るように変更
2026-10-24 異常時にLED点灯に変更
2026-10-24 LCDに時間表示を追加
2026-10-24 日付のjsonまわり対応
2026-10-24 時刻表示の原因調査
2026-10-24 時刻取得失敗時の情報をLCDに出力
2026-10-24 時刻修正
2026-10-24 +HTTPCLIENT 連結 + time 探索
2026-10-24 200ｍｓまちに変更
2026-10-24 ミス対応
2026-10-24 jsonのtimeはやめた
2026-10-24 調査もーど
2026-10-24 複数 URC を連結してから parse
2026-10-25 時間表示は一旦消去
2026-10-25 ops失敗対策
2026-10-25 T-10,T11検査ダミー
2026-10-25 ダミーWIFI消去
2026-10-25 7.2 判定のダミー追加
2026-10-25 送信履歴追加
